Iruretagoyena/Ocean_Drifter/Tapa.stl

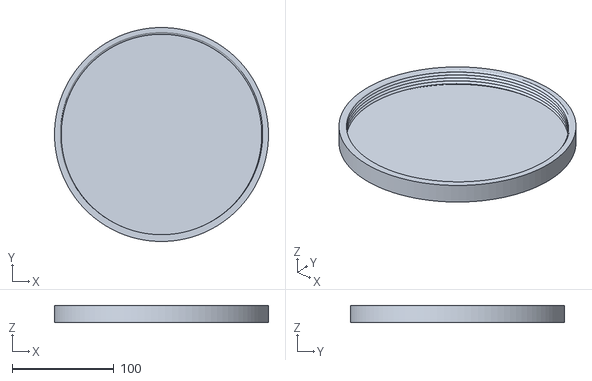
[picture p9: CAD file, 2022-06-30]
Tapa.stl
210.0 x 209.9 x 17.0
