Iruretagoyena/Ocean_Drifter/Cilindro.stl

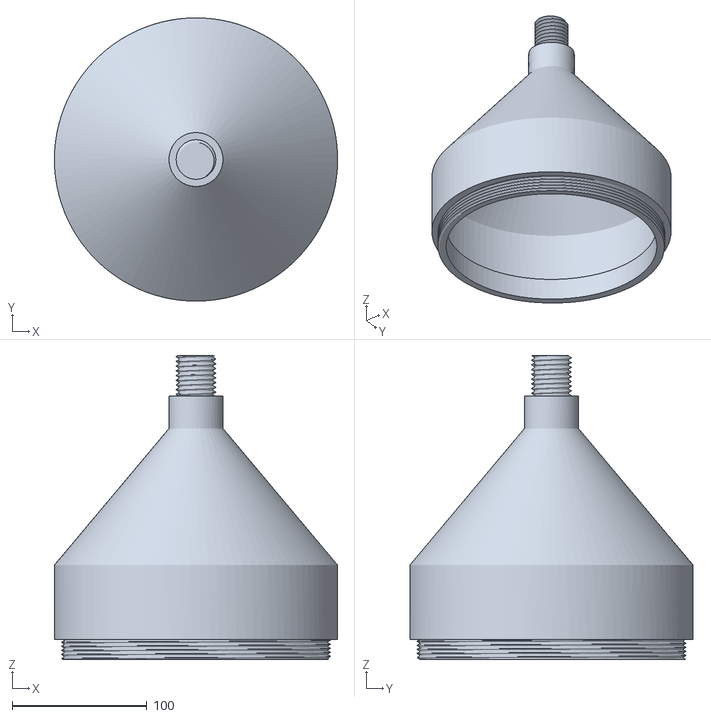
[picture p10: CAD file, 2022-06-30]
Cilindro.stl
210.0 x 210.0 x 225.4
