Iruretagoyena/Ocean_Drifter/Drifter.stl

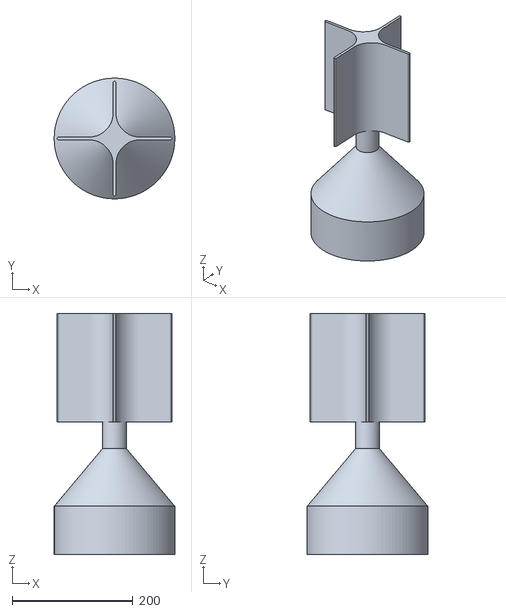
[picture p11: CAD file, 2022-06-30]
Drifter.stl
199.9 x 200.0 x 399.4
