Iruretagoyena/Ocean_Drifter/Aspas.stl

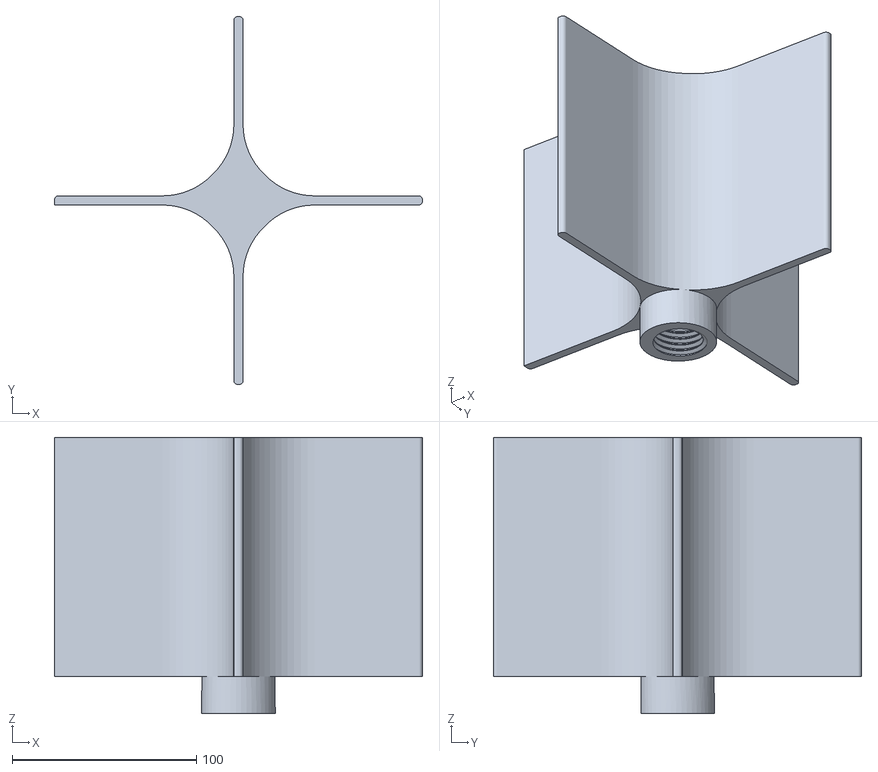
[picture p12: CAD file, 2022-06-30]
Aspas.stl
200.0 x 200.0 x 150.0
